ArekKocowicz/spedo/README.md

# spedo
Bicycle display supplied from dynamo hub (no speed sensor needed, no battery needed)
