ArekKocowicz/spedo/(list of files, cad)

Other CAD files:
dist/default/production/spedo.X.production.obj
l.obj
