ArekKocowicz/spedo/hardware/spedo_pcb_1.brd

## EAGLE design hardware/spedo_pcb_1.brd (2015-02-16)

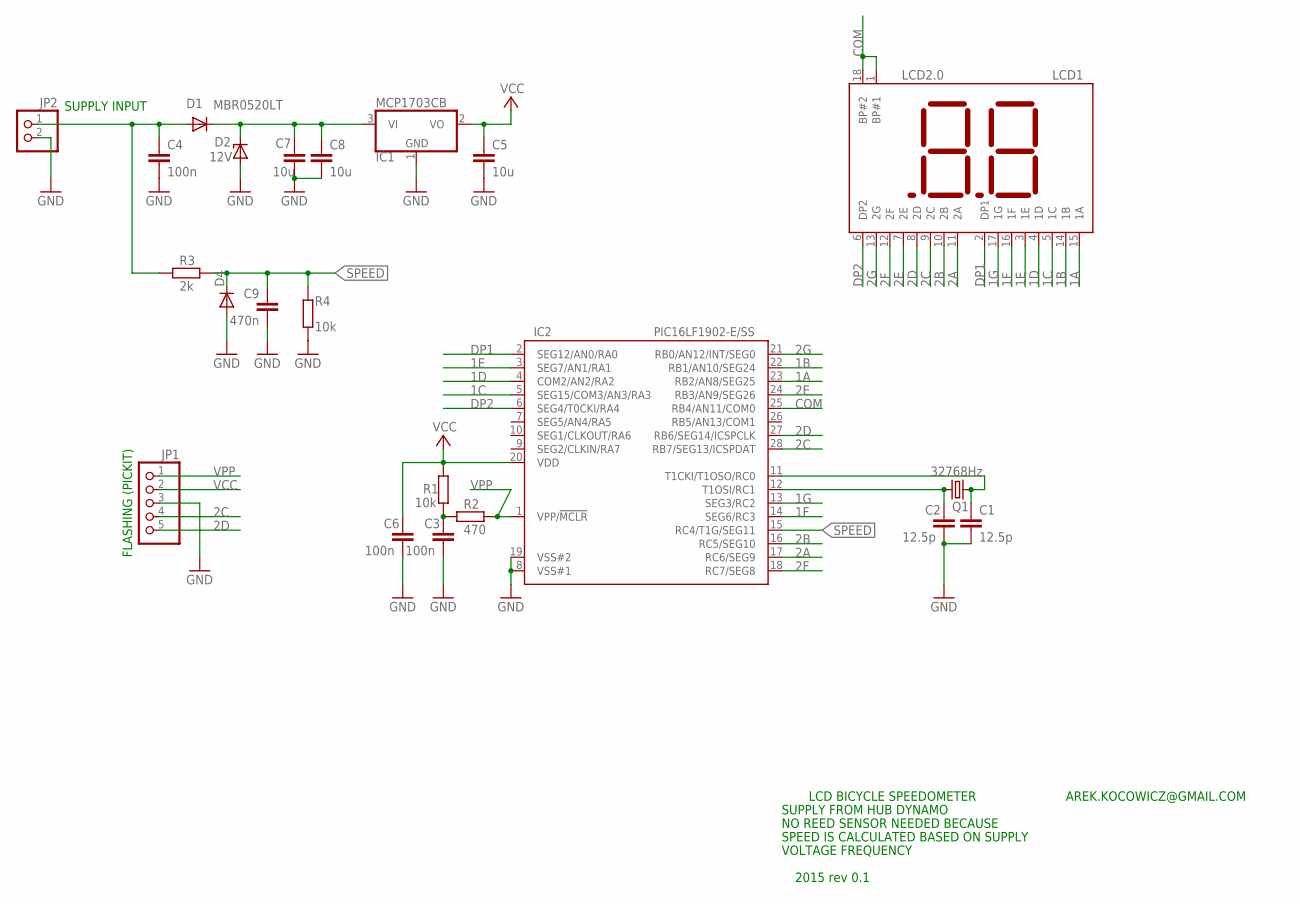
[picture p1: schematic spedo_pcb_1.sch]

Parts:
C1, C2: 12.5p; C0603K
C3, C4, C6: 100n; C0603K
C5, C7, C8: 10u; C0805K
C9: 470n; C0603K
D1: MBR0520LT; SOD123
D2: 12V; SOD80C
D4: DIODE-SOD323-W; SOD323-W
IC1: MCP1703CB; SOT23
IC2: PIC16LF1902-E/SS; SSOP28
JP1: PINHD-1X5/90; 1X05/90
JP2: PINHD-1X2; 1X02
LCD1: LCD2.0
Q1: 32768Hz; TC26H
R1, R4: 10k; R0603
R2: 470; R0603
R3: 2k; R0603

Connections:
1A: IC2.23 (RB2/AN8/SEG25), LCD1.15 (1A)
1B: IC2.22 (RB1/AN10/SEG24), LCD1.14 (1B)
1C: IC2.5 (SEG15/COM3/AN3/RA3), LCD1.5 (1C)
1D: IC2.4 (COM2/AN2/RA2), LCD1.4 (1D)
1E: IC2.3 (SEG7/AN1/RA1), LCD1.3 (1E)
1F: IC2.14 (SEG6/RC3), LCD1.16 (1F)
1G: IC2.13 (SEG3/RC2), LCD1.17 (1G)
2A: IC2.17 (RC6/SEG9), LCD1.11 (2A)
2B: IC2.16 (RC5/SEG10), LCD1.10 (2B)
2C: IC2.28 (RB7/SEG13/ICSPDAT), JP1.4, LCD1.9 (2C)
2D: IC2.27 (RB6/SEG14/ICSPCLK), JP1.5, LCD1.8 (2D)
2E: IC2.24 (RB3/AN9/SEG26), LCD1.7 (2E)
2F: IC2.18 (RC7/SEG8), LCD1.12 (2F)
2G: IC2.21 (RB0/AN12/INT/SEG0), LCD1.13 (2G)
COM: IC2.25 (RB4/AN11/COM0), LCD1.1 (BP#1), LCD1.18 (BP#2)
DP1: IC2.2 (SEG12/AN0/RA0), LCD1.2 (DP1)
DP2: IC2.6 (SEG4/T0CKI/RA4), LCD1.6 (DP2)
GND: C1.2, C2.2, C3.2, C4.2, C5.2, C6.2, C7.2, C8.2, C9.2, D2.A, D4.A, IC1.1 (GND), IC2.8 (VSS#1), IC2.19 (VSS#2), JP1.3, JP2.2, R4.2
unnamed: C1.1, IC2.11 (T1CKI/T1OSO/RC0), Q1.2
unnamed: C2.1, IC2.12 (T1OSI/RC1), Q1.1
unnamed: C4.1, D1.A, JP2.1, R3.1
unnamed: C3.1, R1.2, R2.1
unnamed: C7.1, C8.1, D1.C, D2.C, IC1.3 (VI)
SPEED: C9.1, D4.C, IC2.15 (RC4/T1G/SEG11), R3.2, R4.1
VCC: C5.1, C6.1, IC1.2 (VO), IC2.20 (VDD), JP1.2, R1.1
VPP: IC2.1 (VPP/!MCLR), JP1.1, R2.2

Notes on the sheet:
AREK.KOCOWICZ@GMAIL.COM
LCD BICYCLE SPEEDOMETER
SUPPLY FROM HUB DYNAMO
NO REED SENSOR NEEDED BECAUSE
SPEED IS CALCULATED BASED ON SUPPLY
VOLTAGE FREQUENCY
FLASHING (PICKIT)
SUPPLY INPUT
2015 rev 0.1

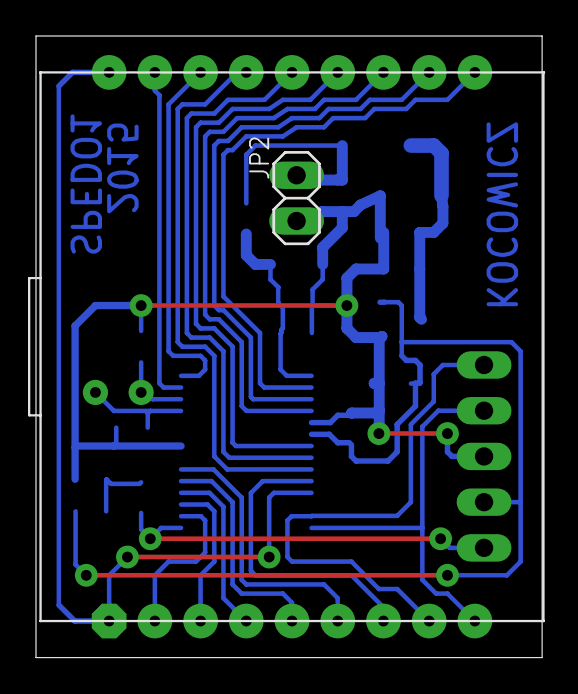
[picture p2: board spedo_pcb_1.brd from above]

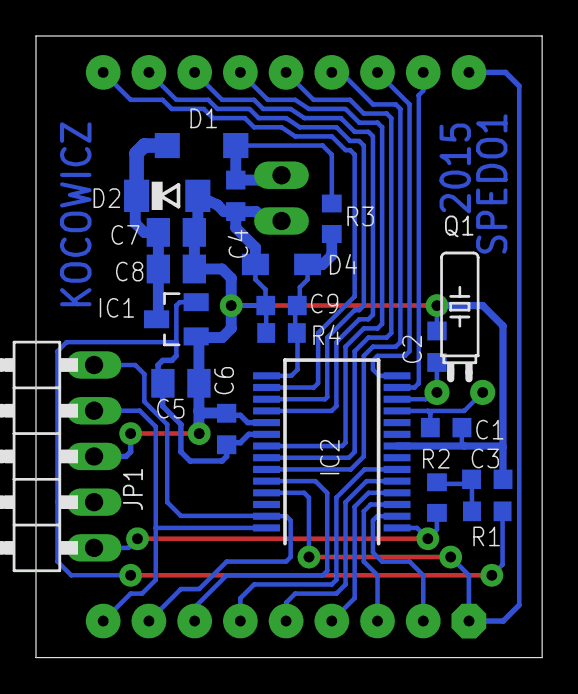
[picture p3: board spedo_pcb_1.brd from below]

Board: 2 copper layers, 28.1 x 34.5 mm, 22 parts (20 on the bottom side), 26 nets.
