ArekKocowicz/spedo/(commit log)

2015-02-16 Added circuit, PCB and gerber files
    [spedo_pcb_1.brd, spedo_pcb_1.sch]
2015-02-22 Changed the way LCD display is controlled. In the first prototype SEG_A was controlled from the same bit in DATAn register. This was easier to code but such a PCB layout was not possible to keep on a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
    [l.obj]
2015-02-23 Further rework on LCD. I added neatly packed dot status as a input for the lcdDisplay function. LCD functions are now in a separate file.
    [l.obj]
2015-03-02 Added lcdDisplayAll which takes a number as an argument and displays it on two digits if no blanking selected in argument. If blanking selected then display shows --. Leading zero is blanked.
    [l.obj]
2015-05-14 fixed LCD pinout, added speed calculation and limiting of displayed values to 99
    [l.obj]
2015-05-15 this software version has been flashed to a prototype mounted on a bicycle.
    [l.obj]
2015-12-30 this version supports storing wheel circumference in flash memory.
